AKstudios/element-pro/README.md

# element-pro
Wireless air quality sensor based on RFM69

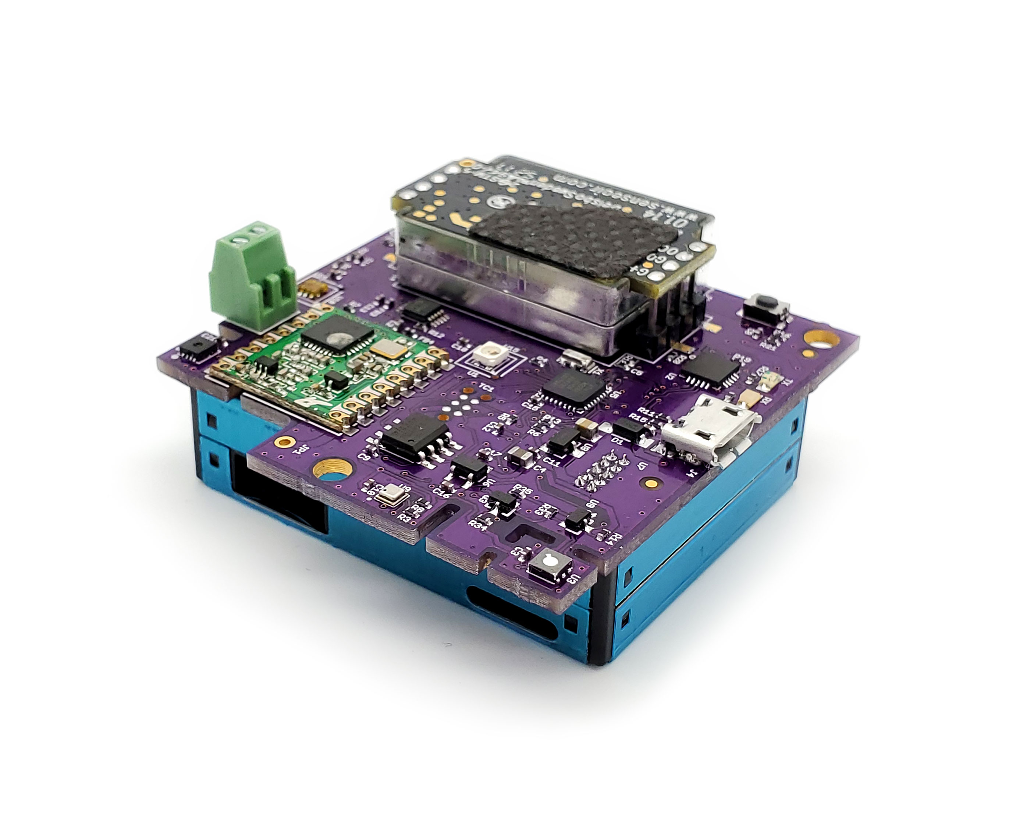
[picture p1: ep_0.jpg]
element pro
