AKstudios/element-pro/hardware/element-pro.brd

## EAGLE design hardware/element-pro.brd (2019-07-01)

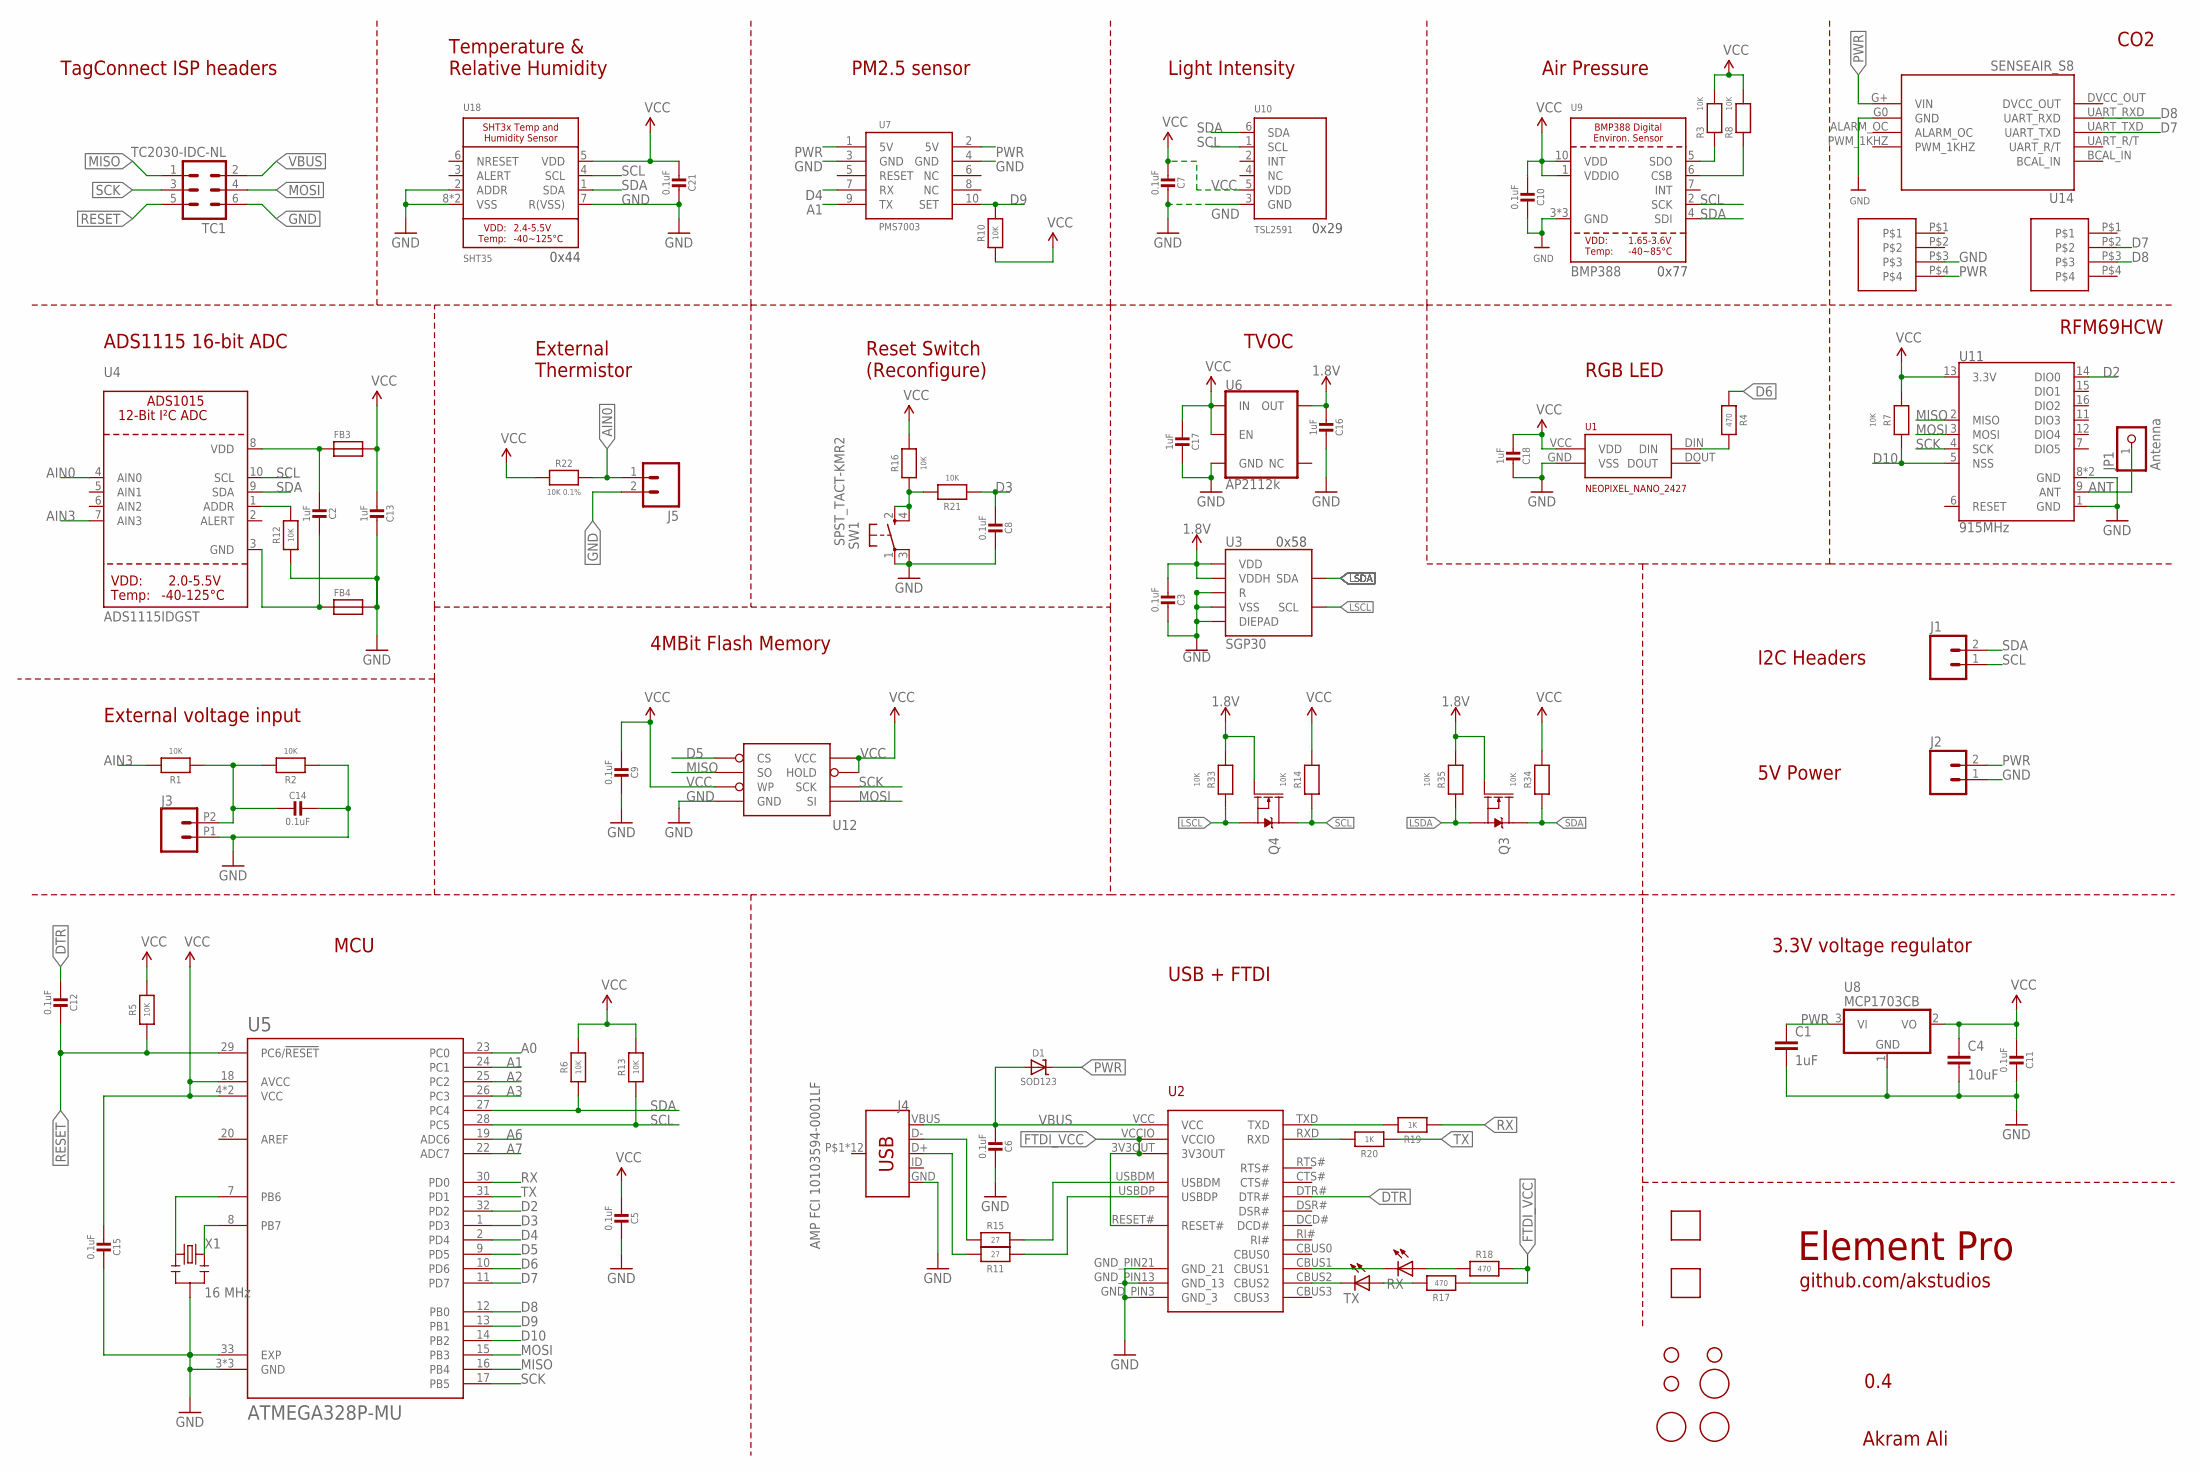
[picture p2: schematic element-pro.sch]

Parts:
C1: 1uF; 0805@1; MPN CC0805ZRY5V8BB105
C2, C13, C16, C17: 1uF; MICROBUILDER__0402MP; MPN GRM155R71C104KA88J
C3, C5, C6, C7, C8, C9, C10, C11, C12, C14, C15, C21: 0.1uF; MICROBUILDER__0402MP; MPN GRM155R71C104KA88J
C4: 10uF; 0805@1; MPN CC0805KKX5R6BB106
C18: 1uF; MICROBUILDER__0402MP; MPN CC0402KRX5R6BB105
D1: SOD123; MICROBUILDER_SOD-123; MPN SD103AW-13-F
FB3, FB4: FERRITE0402; 0402
H1, H2, H3: STAND-OFF
J1, J2, J5: M02PTH; 1X02@1
J3: CONN_022.54MM_SCREWTERM; 1X02_2.54_SCREWTERM
J4: AMP FCI 10103594-0001LF; USB-MICROB-PTH
JP1: Antenna; 1X01-CLEANBIG; MPN Helical antenna
Q3, Q4: BSS138PW,115; SOT323
R1, R2, R3, R5, R6, R7, R8, R10, R12, R13, R14, R16, R21, R33, R34, R35: 10K; MICROBUILDER__0402MP; MPN RC0402JR-0710KL
R4, R17, R18: 470; MICROBUILDER__0402MP; MPN RC0402JR-07470RL
R11, R15: 27; MICROBUILDER__0402MP; MPN RC0402JR-0727RL
R19, R20: 1K; MICROBUILDER__0402MP; MPN RC0402JR-071KL
R22: 10K 0.1%; MICROBUILDER__0402MP; MPN RC0402JR-0727RL
RX: LEDCHIPLED_0805; CHIPLED_0805; MPN LG R971-KN-1
SW1: SPST_TACT-KMR2; KMR2
TC1: TC2030-IDC-NL
TX: LEDCHIPLED_0805; CHIPLED_0805; MPN LG R971-KN-1
U1: NEOPIXEL_NANO_2427; SK6805-2427; MPN 3484
U2: FT231XQ-R; FTDI_FT231XQ-R_PACKAGE; MPN FT231XQ-R
U3: SGP30
U4: ADS1115IDGST; MSOP10
U5: ATMEGA328P-MU; QFN50P500X500X100-33N; MPN ATMEGA328P-MU
U6: AP2112k; SOT23-5
U7: PMS7003; PMS7003_RECEPTACLE_1.27MM_2X5; MPN 20021311-00012T4LF
U8: MCP1703CB; SOT23; MPN MCP1703T-3302E/CB
U9: BMP388
U10: TSL2591; DFN6_TAOS; MPN TSL25911FN
U11: 915MHz; RFM69HCW-XXXS2; MPN RFM69HCW
U12: W25X40CLSNIG-ND-AT25F512BJEDEC_3.9MM; SO08
U14: SENSEAIR_S8
U15: VLP-450-F; MPN VLP-650-F
U16: VLP-450-F; MPN VLP-550-F
U18: SHT35; SHT3X; MPN SHT35-DIS-B
U$1, U$2, U$3: FIDUCIAL; FIDUCIAL_1MM
U$4, U$5: 0878980426; CONN_4POS_VERT_2.54_SMD; MPN 0878980426
X1: 16 MHz; RESONATOR-SMD; MPN CSTCE16M0V53-R0

Connections:
1.8V: C3.2, C16.2, Q3.1 (G), Q4.1 (G), R33.2, R35.2, U3.1 (VDD), U3.5 (VDDH), U6.5 (OUT)
A0: U5.23 (PC0)
A1: U5.24 (PC1), U7.9 (TX)
A2: U5.25 (PC2)
A3: U5.26 (PC3)
A6: U5.19 (ADC6)
A7: U5.22 (ADC7)
ADDR: R12.2, U4.1 (ADDR)
ADR: R3.1, U9.5 (SDO)
AIN0: J5.1, R22.2, U4.4 (AIN0)
AIN3: R1.2, U4.7 (AIN3)
ANT: JP1.1, U11.9 (ANT)
CS: R8.1, U9.6 (CSB)
D2: U5.32 (PD2), U11.14 (DIO0)
D3: C8.2, R21.1, U5.1 (PD3)
D4: U5.2 (PD4), U7.7 (RX)
D5: U5.9 (PD5), U12.1_CS (CS)
D6: R4.1, U5.10 (PD6)
D7: U5.11 (PD7), U14.UART_TXD, U$5.P$2
D8: U5.12 (PB0), U14.UART_RXD, U$5.P$3
D9: R10.2, U5.13 (PB1), U7.10 (SET)
D10: R7.1, U5.14 (PB2), U11.5 (NSS)
DTR: C12.2, U2.DTR#
FTDI_VCC: R17.1, R18.2, U2.3V3OUT, U2.RESET#, U2.VCCIO
GND: C1.2, C3.1, C4.2, C5.1, C6.1, C7.1, C8.1, C9.1, C10.1, C11.1, C13.1, C14.1, C15.1, C16.1, C17.1, C18.1, C21.1, FB4.2, J2.1, J3.P1 (1), J4.GND, J5.2, R2.1, R12.1, SW1.1, SW1.3 (P1), TC1.6, U1.GND (VSS), U2.GND_PIN3 (GND_3), U2.GND_PIN13 (GND_13), U2.GND_PIN21 (GND_21), U3.2 (VSS), U3.4 (R), U3.DIEPAD, U5.3 (GND), U5.5 (GND), U5.21 (GND), U5.33 (EXP), U6.2 (GND), U7.3 (GND), U7.4 (GND), U8.1 (GND), U9.3 (GND), U9.8 (GND), U9.9 (GND), U10.3 (GND), U11.1 (GND), U11.8 (GND), U11.10 (GND), U12.4_GND (GND), U14.G0 (GND), U18.2 (ADDR), U18.7 (R(VSS)), U18.8 (VSS), U18.THERMAL (VSS), U$4.P$3, X1.2
LSCL: Q4.2 (S), R33.1, U3.6 (SCL)
LSDA: Q3.2 (S), R35.1, U3.3 (SDA)
MISO: TC1.1, U5.16 (PB4), U11.2 (MISO), U12.2_SO (SO)
MOSI: TC1.4, U5.15 (PB3), U11.3 (MOSI), U12.5_SI (SI)
unnamed: R4.2, U1.DIN
unnamed: R20.2, U2.RXD
unnamed: R19.2, U2.TXD
unnamed: U5.8 (PB7), X1.3
unnamed: U5.7 (PB6), X1.1
unnamed: C14.2, J3.P2 (2), R1.1, R2.2
unnamed: C2.1, FB4.1, U4.3 (GND)
unnamed: C2.2, FB3.1, U4.8 (VDD)
unnamed: R16.1, R21.2, SW1.2 (S), SW1.4 (S1)
unnamed: RX.C, U2.CBUS1
unnamed: TX.C, U2.CBUS2
unnamed: R15.2, U2.USBDM
unnamed: R11.1, U2.USBDP
unnamed: R18.1, RX.A
unnamed: R17.2, TX.A
unnamed: J4.D-, R15.1
unnamed: J4.D+, R11.2
PWR: C1.1, D1.C, J2.2, U7.1 (5V), U7.2 (5V), U8.3 (VI), U14.G+ (VIN), U$4.P$4
RESET: C12.1, R5.1, TC1.5, U5.29 (PC6/!RESET)
RX: R19.1, U5.30 (PD0)
SCK: TC1.3, U5.17 (PB5), U11.4 (SCK), U12.6_SCK (SCK)
SCL: J1.1, Q4.3 (D), R13.1, R14.1, U4.10 (SCL), U5.28 (PC5), U9.2 (SCK), U10.1 (SCL), U18.4 (SCL)
SDA: J1.2, Q3.3 (D), R6.1, R34.1, U4.9 (SDA), U5.27 (PC4), U9.4 (SDI), U10.6 (SDA), U18.1 (SDA)
TX: R20.1, U5.31 (PD1)
VBUS: C6.2, D1.A, J4.VBUS, TC1.2, U2.VCC
VCC: C4.1, C5.2, C7.2, C9.2, C10.2, C11.2, C13.2, C15.2, C17.2, C18.2, C21.2, FB3.2, R3.2, R5.2, R6.2, R7.2, R8.2, R10.1, R13.2, R14.2, R16.2, R22.1, R34.2, U1.VCC (VDD), U5.4 (VCC), U5.6 (VCC), U5.18 (AVCC), U6.1 (IN), U6.3 (EN), U8.2 (VO), U9.1 (VDDIO), U9.10 (VDD), U10.5 (VDD), U11.13 (3.3V), U12.3_WP (WP), U12.7_HOLD (HOLD), U12.8_VCC (VCC), U18.5 (VDD)

Notes on the sheet:
Light Intensity
Air Pressure
4MBit Flash Memory
Temperature & Relative Humidity
TagConnect ISP headers
3.3V voltage regulator
Element Pro
Akram Ali
USB + FTDI
0.4
github.com/akstudios
0x29
RGB LED
I2C Headers
PM2.5 sensor
RFM69HCW
MCU
CO2
TVOC
5V Power
Reset Switch (Reconfigure)
0x58
0x44
0x77
ADS1115 16-bit ADC
External Thermistor
External voltage input

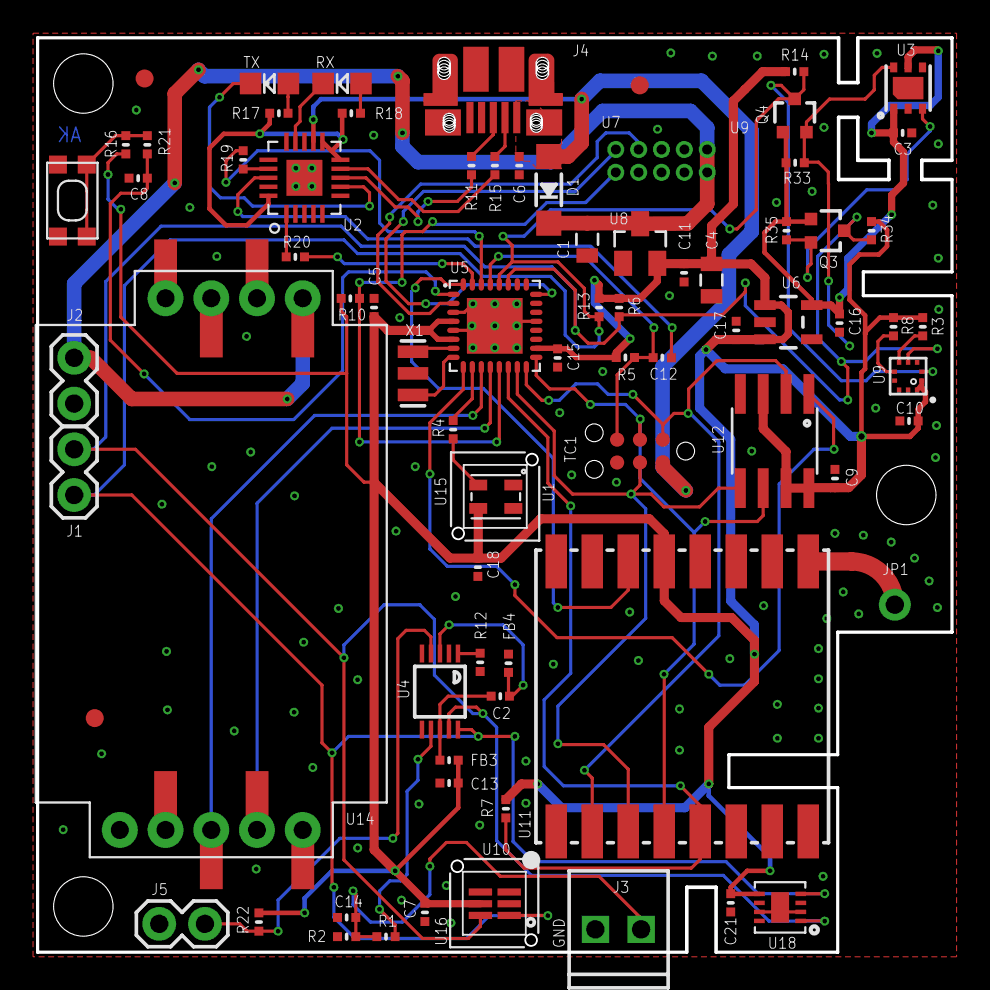
[picture p3: board element-pro.brd from above]

Board: 2 copper layers, 50.8 x 50.8 mm, 83 parts (1 on the bottom side), 50 nets.
