AKstudios/element-pro/(commit log)

2019-03-03 silkscreen, nibbletz adjustment
    [element-pro.brd]
2019-03-03 updated swag
    [element-pro.brd, element-pro.sch]
2019-05-29 v0.2 - design update
    - moved T/RH sensor away from top
    - moved thermistor + ADC away from top
    - moved VOC sensor from bottom
    - repositioned pressure sensor
    - added more isolation to all necessary sensors
    - a lot of trace and component placement adjustments
    - added external voltage input
    - ERC/DRC
    - silkscreen update
    - added gerbers
    - NOTE: BOM not updated; untested design
    [element-pro.brd, element-pro.sch]
2019-06-26 v0.3 update
    moved stuff around a bit - functionalluy the same as before.
    [element-pro.brd]
2019-06-26 branding modification
    [element-pro.sch]
2019-06-27 Updated firmware for v0.2
    - PM sensor code still untested - two software serials?
2019-06-28 firmware update
    - added PM sensor enable/disable feature
    - changed external thermistor to external voltage
    - added auto gain for external voltage input
    - fixed CO2 sensor reading
    - fixed temperature reading from thermistor
    - minor changes to final datapacket
    - fixed various other parts of code
    [firmware.ino]
2019-07-01 v0.4 - repositioning sensors
    - better heat management
    - added more thermal breaks on board
    - rearranged many traces
    - erc/drc
    [element-pro.brd, element-pro.sch]
